thesunRider/MVUS/Circuit Layout/datasheets/Pasted image 20220810203418.png

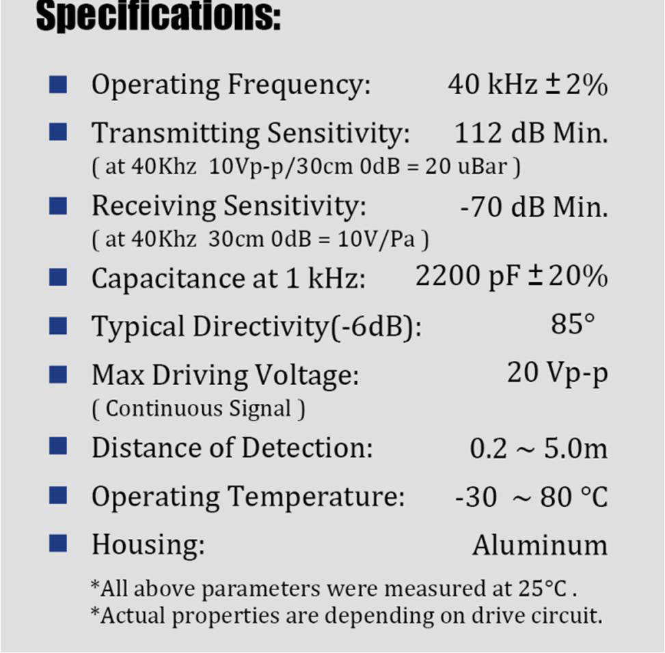
Circuit Layout/datasheets/Pasted image 20220810203418.png
