thesunRider/MVUS/Circuit Layout/datasheets/Pasted image 20220810205248.png

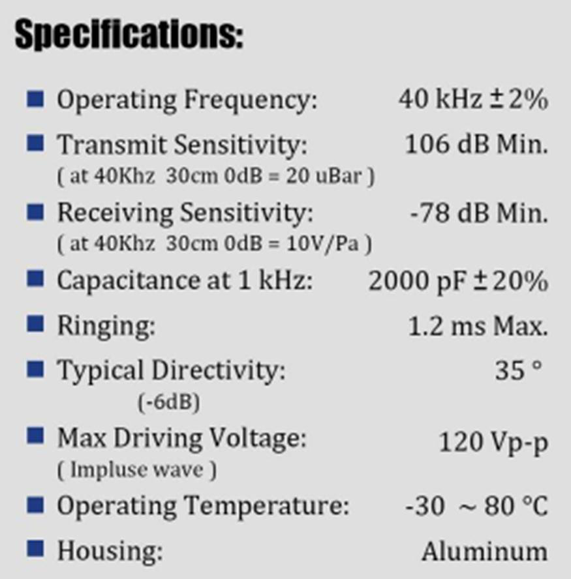
Circuit Layout/datasheets/Pasted image 20220810205248.png
