thesunRider/MVUS/Circuit Layout/datasheets/Pasted image 20220821035351.png

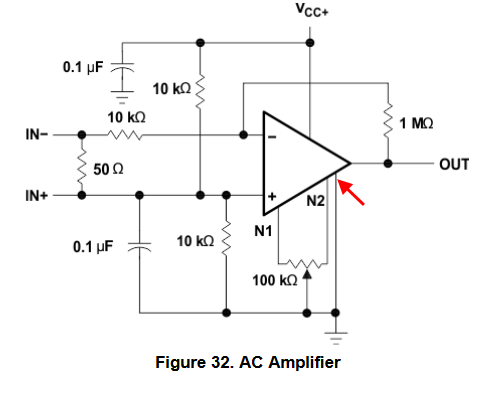
Circuit Layout/datasheets/Pasted image 20220821035351.png
