thesunRider/MVUS/documentation/images/Pasted image 20220816051546.png

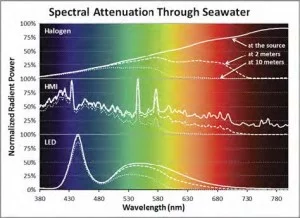
documentation/images/Pasted image 20220816051546.png
