thesunRider/MVUS/documentation/images/Pasted image 20220816171746.png

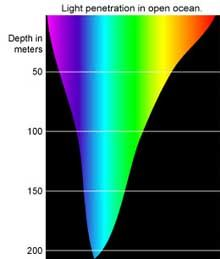
documentation/images/Pasted image 20220816171746.png
