thesunRider/MVUS/documentation/images/Pasted image 20220821025454.png

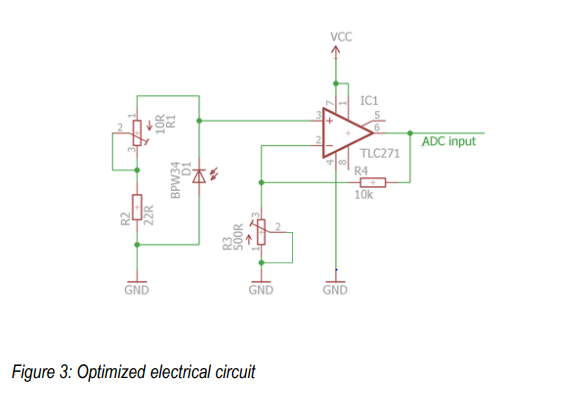
documentation/images/Pasted image 20220821025454.png
