thesunRider/MVUS/documentation/research/Pasted image 20220813053814.png

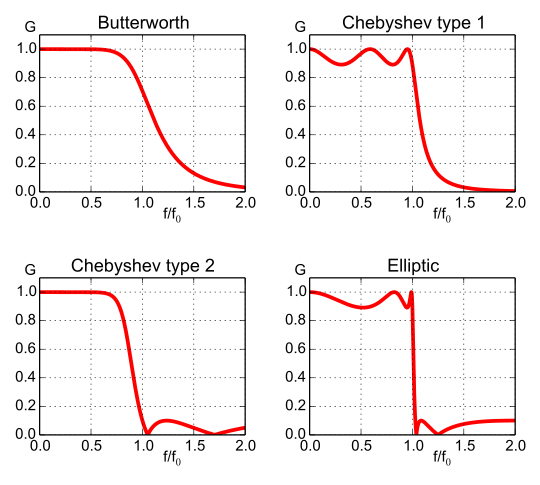
documentation/research/Pasted image 20220813053814.png
