thesunRider/MVUS/(list of files, drawings)

Other design files:
simulation/Project Backups/test_amp [20220813, 17-57-41].pdsprj
simulation/Project Backups/test_amp [20220813, 17-58-08].pdsprj
simulation/Project Backups/test_amp [20220813, 17-58-26].pdsprj
simulation/Project Backups/test_amp [20220813, 17-58-47].pdsprj
simulation/Project Backups/test_amp [20220813, 18-04-01].pdsprj
simulation/Project Backups/test_amp [20220813, 18-45-42].pdsprj
simulation/Project Backups/test_amp [20220813, 18-49-12].pdsprj
simulation/Project Backups/test_amp [20220813, 22-51-28].pdsprj
simulation/Project Backups/test_amp [20220816, 19-21-12].pdsprj
simulation/Project Backups/test_amp [20220818, 21-39-34].pdsprj
simulation/Project Backups/test_bridge [20220812, 20-26-32].pdsprj
simulation/Project Backups/test_led_driver [20220819, 21-37-24].pdsprj
simulation/Project Backups/test_led_driver [20220819, 22-07-57].pdsprj
simulation/Project Backups/test_led_driver [20220819, 22-11-08].pdsprj
simulation/Project Backups/test_led_driver [20220819, 22-12-37].pdsprj
simulation/Project Backups/test_led_driver [20220819, 22-13-08].pdsprj
simulation/Project Backups/test_led_driver [20220819, 22-13-15].pdsprj
simulation/Project Backups/test_led_driver [20220819, 23-21-36].pdsprj
simulation/Project Backups/test_led_driver [20220819, 23-22-18].pdsprj
simulation/Project Backups/test_led_driver [20220819, 23-24-13].pdsprj
simulation/Project Backups/test_led_driver [20220819, 23-25-20].pdsprj
simulation/test_amp.pdsprj
simulation/test_bridge.pdsprj
simulation/test_led_driver.pdsprj
simulation/test_lightreciever.pdsprj
simulation/test_vco.pdsprj
