thesunRider/MVUS/(commit log)

2022-08-11 Literature Study
    [test_bridge [20220811, 15-44-07].pdsprj, test_bridge.pdsprj, test_vco [20220811, 00-27-59].pdsprj, test_vco [20220811, 00-44-05].pdsprj, test_vco [20220811, 15-29-47].pdsprj, test_vco [20220811, 15-30-53].pdsprj, test_vco.pdsprj]
2022-08-20 Documentations added
    [test_amp [20220813, 17-57-41].pdsprj, test_amp [20220813, 17-58-08].pdsprj, test_amp [20220813, 17-58-26].pdsprj, test_amp [20220813, 17-58-47].pdsprj, test_amp [20220813, 18-04-01].pdsprj, test_amp [20220813, 18-45-42].pdsprj, test_amp [20220813, 18-49-12].pdsprj, test_amp [20220813, 22-51-28].pdsprj]
2022-08-20 Added Light Communication
    [attentuation_vs_distance.xlsx]
